MostlyFunctionalEngineering/pocket-computer/cad/README.md

# CAD files

The 3D-printable case files go in this folder.

> **Assembly caveat:** I kind of threw this together very quickly. The CAD assembly doesn't go together very well on its own. You'll
> need to glue a lot. It did work, and the
> [build video](https://youtu.be/sdcX1ghOkFM) shows where everything is placed.
