MostlyFunctionalEngineering/pocket-computer/cad/Plastic Top Shell.stl

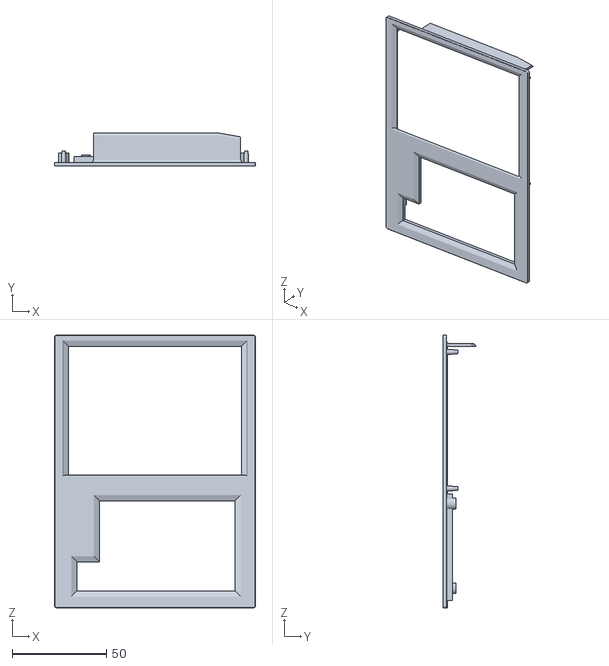
[picture p2: CAD file, 2026-10-20]
cad/Plastic Top Shell.stl
107.0 x 17.7 x 145.1
