MostlyFunctionalEngineering/pocket-computer/cad/Plastic Bottom Shell.stl

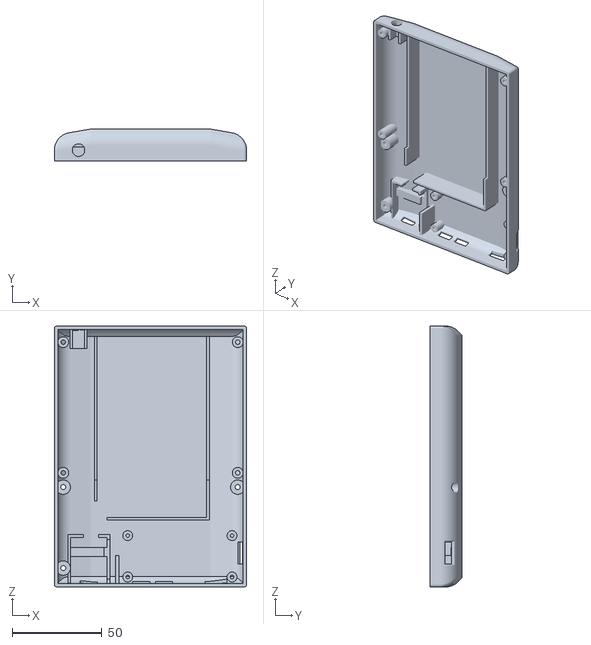
[picture p3: CAD file, 2026-10-20]
cad/Plastic Bottom Shell.stl
107.0 x 17.7 x 145.1
